yujize5811/can-gateway/README.md

# CAN 双节点网关（CAN-GW v1）

STM32F103CBT6 双节点 CAN 总线通信项目。重点不在「两块板能通信」，而在**位定时算对、多帧传得完、故障能恢复、长跑不丢帧**。

> **本仓库唯一的规则**
> README 和简历里出现的每一个数字，都必须在 `docs/04-pitfalls.md` 或 `docs/records/` 里找到对应的原始记录。
> 没有记录的数字不写。面试官会追问出处，答不上来整个项目就废了。

---

## 1. 硬件

| 物料 | 型号 | 数量 | 说明 |
|---|---|---|---|
| MCU | STM32F103**CBT6** | 2 | 128 KB Flash。买 C8T6 做不了后面的 Bootloader |
| CAN 收发器 | SN65HVD230 | 2 | 3.3 V 器件，与 MCU 电平天然匹配 |
| 终端电阻 | 120 Ω | 2 | 跨接在总线两端，**不是串联** |
| 分析仪 | USB-CAN（PCAN 兼容） | 1 | 旁路抓包，防止自己统计自己 |
| 串口 | CH340 USB-TTL | 1 | 打印日志 |

接线见 [`hardware/wiring.md`](hardware/wiring.md)。

## 2. 架构

```
   节点 A (STM32)                节点 B (STM32)
   ┌──────────┐                 ┌──────────┐
   │ 应用层    │  0x2xx 周期数据  │ 应用层    │
   │ 协议层    │ ───────────────▶│ 协议层    │
   │ bxCAN     │  0x5xx ACK      │ bxCAN     │
   └────┬─────┘ ◀───────────────└────┬─────┘
        │ CANH/CANL                   │
   ┌────┴─────────────────────────────┴─────┐
   │            USB-CAN 分析仪（旁路）        │
   └────────────────────────────────────────┘
```

## 3. 指标

> 下列数值全部为**待实测**。测完把数字填进来，并在 `docs/records/` 留下原始 CSV 或截图。

| 类别 | 指标 | 目标 | 实测 |
|---|---|---|---|
| 通信 | 波特率 / 采样点 | 500 kbps / 77.8 % | 500 kbps ✅ 收帧稳定；采样点待示波器验证 |
| 负载 | 业务态帧率与总线负载 | 50 帧/s ≈ 1.3 % | **21.0 ms / 47.6 帧/s ≈ 1.0 %**（实测 1529 帧） |
| 负载 | 灌包时总线负载上限 | 1500 帧/s ≈ 40 % | ⏳ |
| 稳定性 | 72 h 累计帧数、应用层丢帧 | ≈ 1296 万帧 / 0 | ⏳ |
| 多帧 | 1 KB 分片传输成功率 | 100 % | ⏳ |
| 吞吐 | 1 KB 停等 vs 滑窗耗时 | 8.6 s → 1.7 s | ⏳ |
| 恢复 | Bus-Off 后自动恢复时间 | < 200 ms | ⏳ |
| 离线上线 | 判离线 / 恢复上线 | 3 个心跳周期 / < 2 s | ⏳ |
| 实时性 | 中断到任务处理延迟 | P99 < 500 µs | ⏳ |

怎么测、测多久、记录什么，见 [`docs/03-test-plan.md`](docs/03-test-plan.md)。

## 4. 目录

```
can-gateway/
├── docs/
│   ├── 01-can-timing.md      位定时推导（本项目最值钱的一份文档）
│   ├── 02-protocol.md        CAN-GW v1 应用层协议
│   ├── 03-test-plan.md       每个指标怎么测
│   ├── 04-pitfalls.md        踩坑记录：现象 → 排查 → 根因 → 代价
│   └── records/              测试原始记录（摘要入库，CSV 不入库）
├── firmware/                 STM32 工程（编译产物不入库）
├── hardware/
│   └── wiring.md             接线、120 Ω 规则、上电前检查
└── tools/                    上位机脚本（Python 3，仅依赖 python-can）
```

## 5. 快速复现

```bash
# 1. 装依赖
pip install python-can

# 2. 自检：驱动、接口、设备
python tools/can_check.py

# 3. 抓包到 CSV（默认 PCAN_USBBUS1 @ 500 kbps）
python tools/can_logger.py -t 60 -o run_001.csv

# 4. 分析：帧率、周期抖动、丢帧
python tools/analyze_log.py run_001.csv
```

固件怎么编译、怎么烧，见 [`firmware/README.md`](firmware/README.md)。

## 6. 踩过的坑

完整记录见 [`docs/04-pitfalls.md`](docs/04-pitfalls.md)。目前收录：

1. **CBT6 是被改丝印的 C8T6** —— 读 `0x1FFFF7E0` 只有 64 KB，Bootloader 的 128 KB 分区直接崩
2. **终端电阻接成串联** —— 总线电阻变成无穷大，全部节点通信失败
3. **单板发帧报 `TxError`** —— 不是 bug，是没人回 ACK
4. **用了 TJA1050 接非 FT 引脚** —— 5 V 输出灌进 3.3 V IO

## 7. 已知限制

- 只有 2 个节点，没有验证多主仲裁下的优先级反转
- 72 h 压测在单机环境完成，未做温度循环
- 滑窗协议是自定义的，不是 ISO-TP，不能与第三方设备互通

---

## 关于这个仓库

写它是为了回答一个问题：**这个项目是你做的，还是你抄的？**

- `docs/01-can-timing.md` 里的每一步计算都能自己复算
- `docs/04-pitfalls.md` 里的每个坑都有现象和代价，抄不来
- `tools/` 下的脚本是配套的，不是从别处粘的

如果只想看结果，看上面第 3 节的表就行。
