yujize5811/can-gateway/docs/开工自测.md

# 开工自测（每次动代码之前做）

> 规则：**先说「开工」，我先出题。答完再碰代码。**
> 10 分钟以内，答不上来的当场翻 `docs/面试题库.md`，翻完用一句话复述。

---

## 一、固定三问（每次必答，30 秒）

1. **上一次我做了什么？**（用数字说，不许说"跑通了"）
2. **其中一个数字是怎么算出来的？**（比如 47.6 帧/s、77.8%、7380 帧）
3. **如果重做，我会改哪一处？**

---

## 二、随机抽测（3 题）

从 `docs/面试题库.md` 里抽，**优先抽上次刚做的模块**。
答不上来不算失败，答不上来还不翻才算。

---

## 三、记录

| 日期 | 抽到的题 | 答不上来的 | 补了没有 |
|---|---|---|---|
| 2026-11-11 | Q15 位定时 / Q26 幻影丢帧 / Q31 缺口法边界 | — | — |

---

## 四、通过标准

- **能白板画**：帧格式、位定时推导、块传输时序
- **能讲因果**：为什么改这里就好了
- **能说边界**：这个方案在什么条件下会失效

三条里最少占两条，才算"上次真学到了"。
