yujize5811/can-gateway/docs/records/20261111-心跳与离线.md

# 心跳与离线检测（T8）

- 日期：2026-11-11
- 对应指标：T8 离线 / 上线
- 固件 commit：本记录同批提交

## 1. 我预期发生什么

两节点各发两种帧：

| ID | 类型 | 周期 | 内容 |
|---|---|---|---|
| 0x101 / 0x102 | 心跳 | 1000 ms | 上电秒数(2) + 离线次数(2) + 状态(1) |
| 0x201 / 0x202 | 数据 | 21 ms | 发送计数(2) + 丢帧数(2) + 状态(1) |

离线判定：距上次收到对方**任何合法帧**超过 3000 ms 即判离线。

- 正常时两板 `status` 的 bit7 都为 0
- 拔线超过 3 秒，`status` 变 0x80，`offlineCnt` +1
- 插回后 `status` 立刻回 0，`offlineCnt` 不回退

## 2. 实际发生了什么

### 基线（上电约 100 秒）

```
101h  10 65 | 66 00 | 01 00 | 00    1007.9 ms   A 心跳：102 秒，离线 1 次，在线
102h  10 27 | 28 00 | 00 00 | 00     987.0 ms   B 心跳：40 秒，离线 0 次，在线
201h  21 28 | 28 13 | 00 00 | 00      21.0 ms   A 数据：cnt=4904，lost=0
202h  21 83 | 83 07 | 00 00 | 00      21.0 ms   B 数据：cnt=1923，lost=0
```

A 的 `offlineCnt=1` 是开机头 3 秒对方还没起来造成的，属正常。

### 拔线（约 6 秒）

```
102h  10 31 | 32 00 | 02 00 | 80                 B：离线次数 2，status=0x80
202h  21 79 | 79 09 | 01 00 | 80                 B 数据同步显示 0x80
```

### 插回后

```
101h  10 09 | 85 01 | 04 00 | 00    987.1 ms   A：离线 4 次，status=0
102h  10 4D | 4E 00 | 02 00 | 00   1008.2 ms   B：离线 2 次，status=0
201h  21 93 | 93 31 | 62 00 | 00                A：lost=98（拔线期间丢的）
202h  21 A3 | A3 0E | 01 00 | 00                B：lost=1
```

## 3. 差在哪

- `status` 的 bit7 在断线 3 秒后置 1、重连后立刻清 0：符合设计
- `offlineCnt` 只增不减：符合"记跳变次数、不记时长"的设计意图
- A 的 `lost` 涨到 98（≈2 秒），B 只有 1：**这是序号缺口法的固有局限**，谁先丢帧谁记，另一端可能因重连后 `gap>127` 被判成 resync

## 4. 结论·下一步

- 心跳 + 超时能回答"对方还在不在"，序号缺口能回答"丢了多少帧"，两者互补
- 阈值 3000 ms = 心跳周期 3 倍：丢 1~2 个心跳不误判，真断 3 秒内必发现
- 下一步：把 `offlineCnt` 和 `lostCnt` 接进心跳，做一套"断线次数/时长"的统计；再往后进 T4（72 小时压测）
