yujize5811/can-gateway/docs/records/20261103-上电前检查.md

# 上电前检查

- 日期：2026-11-03
- 对应指标：硬件确认（不属于 T1–T9）
- 固件 commit：无

## 1. 我预期发生什么

CANH 与 CANL 之间应约 60 Ω。分析仪 120R 开关打开，加上 HVD230 模块自带 120 Ω，两个 120 Ω 并联。

## 2. 实际发生了什么

万用表电阻档，实测 60.6 ~ 60.7 Ω，末位在 60.6 和 60.7 之间跳动。

## 3. 差在哪

没有差。多出的 0.6 Ω 是表笔线与接触电阻，属正常范围。

## 4. 结论·下一步

终端电阻配置正确，可以上电写代码。

## 记录

- 工具：优利德 UT136B+
- 条件：全部 USB 断开，断电测量
- 接线：分析仪 H/L ↔ HVD230 CANH/CANL
