yujize5811/can-gateway/docs/records/_模板.md

# 记录标题

- 日期：2026-__-__
- 对应指标：T_ / 无
- 固件 commit：

## 1. 我预期发生什么

## 2. 实际发生了什么

```

```

## 3. 差在哪

- 现象：
- 排查过程：
- 根因：
- 修复：
- 代价：

## 4. 结论 / 下一步
