yujize5811/can-gateway/(commit log)

2026-10-31 初始化 CAN 网关项目骨架：文档、接线、工具
2026-10-31 添加 .gitattributes 统一换行符
2026-10-31 增加记录模板与一键新建记录脚本
2026-10-31 精简记录模板：去掉说明性括号，只留空标题
2026-11-01 记录：容量验证，新板 SWD 排针未焊，旧板 0x0040 属正常
    Documented capacity verification for new F103CBT6 boards, detailing expected vs actual results, troubleshooting steps, and conclusions.
2026-11-01 修正：记录文件路径重复，移回 docs/records/
2026-11-03 焊后复测三块均 0x0080
2026-11-03 记录：上电前实测 CANH-CANL 60.6Ω
2026-11-04 记录坑：CubeMX 默认 No Debug 导致烧一次锁死
2026-11-04 记录：CAN 无帧排查，软件层逐项排除
2026-11-04 记录：新增坑#5，用 cnt=3 判定无 ACK
2026-11-04 修正坑#5根因：HVD230 模块损坏（误接 5V）
2026-11-04 记录：业务帧率实测 21.0ms/47.6帧每秒，更新 README 指标表
2026-11-04 记录：11-04 接线照片入库，hardware/wiring.md 增加实拍章节
2026-11-09 记录：双节点互发跑通；补两条坑（ConfigFilter 顺序、Keil 未重编译）
2026-11-09 清理：把 Keil 构建产物移出版本库，补 .gitignore
2026-11-09 清理：删掉误创建的空文件「et --hard HEAD~1」
2026-11-10 新增：CAN-GW v1 协议层 can_proto.h/.c（CRC-8/ATM），注册进 Keil 工程
2026-11-10 协议层跑通：组帧 + CRC8 校验，双节点 rxOk 同步、rxErr 为 0
2026-11-10 功能：丢帧检测跑通（16 位计数 + 缺口判断），补两条坑
2026-11-11 功能：T8 心跳与离线检测跑通（独立 ID + 3 秒超时）
2026-11-11 功能：T5 多帧块传输（START/FRAG/END + 整包 CRC32 + ACK）
2026-11-11 文档：面试题库 v2（48 题）+ 开工自测清单
2026-11-13 功能：NACK 回退重传打通，注入丢包后整包仍 256/256 通过
2026-11-14 记录：T7 Bus-Off 排查（未定位根因），补两条坑
