yujize5811/can-gateway/(notices)

Notices in the files:
firmware/can_gw/Core/Src/main.c:
Copyright (c) 2026 STMicroelectronics.
All rights reserved.
This software is licensed under terms that can be found in the LICENSE file
